QinghuaYao/ECE445-notebook/Michael/notebook.md

# Date: Week of 2/3
https://www.espressif.com/en/products/socs/esp32 <br> https://docs.espressif.com/projects/esp-idf/en/v4.4/esp32s3/api-reference/peripherals/gpio.html <br>
The ESP32 is a low-cost, low-power system on a chip (SoC) with integrated Wi-Fi and Bluetooth, widely used in embedded systems and Internet of Things (IoT) projects. It’s developed by Espressif Systems, a company based in Shanghai.

<br>
Key Features:<br>
- Dual-core Tensilica Xtensa LX6 (or single-core in some variants) <br>
- Wi-Fi (802.11 b/g/n) and Bluetooth 4.2 / BLE <br>
- Up to 520 KB SRAM and support for external flash <br>
- GPIOs, ADC, DAC, UART, SPI, I2C, PWM, and more <br>
- Ultra-low power modes for battery-powered applications <br>
- Integrated Hall sensor and temperature sensor
<br>
ESP32 can be interfaced with other systems to provide WiFi and Bluetooth functionality through SPI / SDIO or I2C / UART interfaces. 

# Date: Week of 2/10
MPU6050 for acceleration data <br>

6-axis MEMS motion tracking device developed by InvenSense (now part of TDK). It combines a 3-axis gyroscope and a 3-axis accelerometer in a single chip, making it ideal for motion-sensing and orientation-tracking applications.<br>

6 Degrees of Freedom (DoF):<br>
- 3-axis accelerometer (±2g, ±4g, ±8g, ±16g)
- 3-axis gyroscope (±250, ±500, ±1000, ±2000 °/sec)
Digital Motion Processor (DMP):
- Onboard processor that can compute complex motion processing algorithms (e.g., sensor fusion) internally, reducing the load on the main microcontroller.
- I²C and SPI communication support
- 16-bit ADCs for each axis (high resolution)
- Power supply: 2.3V–3.4V (typically 3.3V)
<br>
Accelerometer: Measures linear acceleration (e.g., gravity, movement). <br>
Gyroscope: Measures angular velocity (rotation rate). <br>
Temperature sensor: Provides die temperature reading (useful for compensation). <br>

# Date: Week of 2/17
Mostly preparing for proposal review and get started with the PCB

# Date: Week of 2/24
Attached a schematic of our PCB <br>

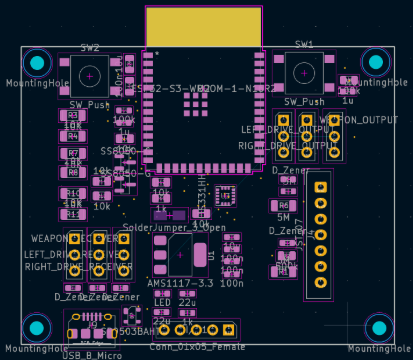
[picture p1: Michael/PCB.png]
PCB


Following is the MPU6050 Pinout <br>
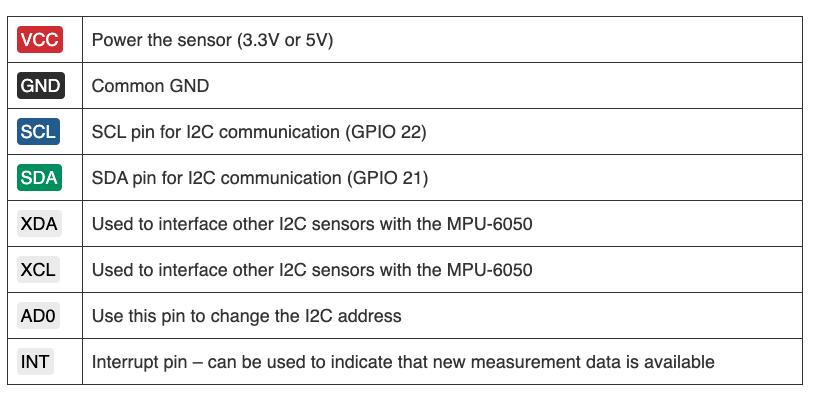
[picture p2: Michael/MPU_Pinout.png]
MPU Pinout


Following is the schematic <br>
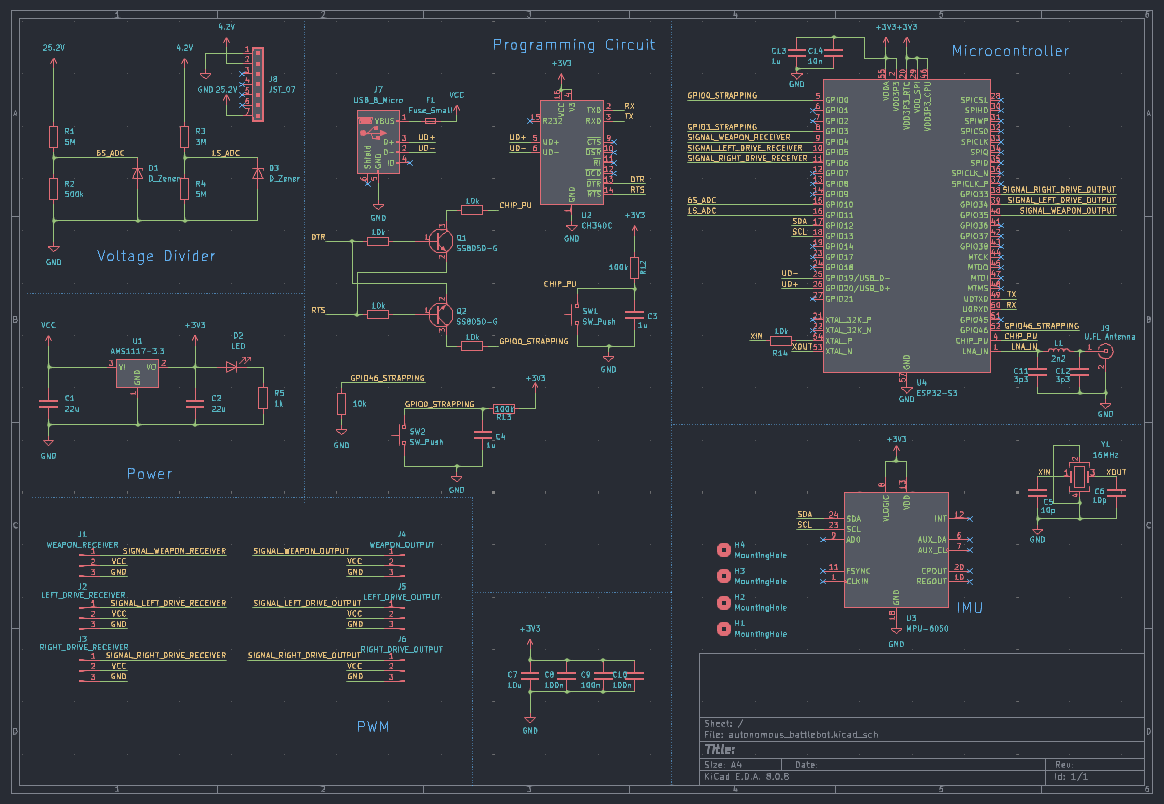
[picture p3: Michael/Schematic.png]
Schematic


After TA meeting and PCB review, everything looks good and I will ordering all the parts. <br>

Update: Order has been done over the weekend.

# Date: Week of 3/3
PCB order has been gone through. <br>

Waiting for the parts to arrive so we can start assembling. <br>

Start working on the design document and start preparing for the breadboard demonstration.<br>

For breadboard demo, we will be showing the AprilTag conversion and basic ESP32 board demonstration using Arduino IDE to test out the acceleration. <br>

https://randomnerdtutorials.com/esp32-mpu-6050-accelerometer-gyroscope-arduino/ <br>

Will be using this tutorial as reference <br>

Uploaded the acceleration.ino for demo

# Date: Week of 3/10
Completed the breadboard demo <br>

Double-check the connection with Bluetooth 
- Doesn't work that well.. Maybe WiFi?
<br>

Not much work done with the parts yet

# Date: Week of 3/17
Spring Break

# Date: Week of 3/24
Missed TA meeting due to midterm <br>

Work on individual progress reports <br>

Placed all the orders for PCB <br>

Update: IMU CHANGE <br>

Changes with IMU as MPU6050 is no longer available <br>

Will be using LIS331 <br>

https://mm.digikey.com/Volume0/opasdata/d220001/medias/docus/2319/LIS331DLH%28TR%29.pdf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 <br>

LIS331 IMU for acceleration data <br>

3-axis MEMS accelerometers developed by STMicroelectronics, designed to measure acceleration in three dimensions (X, Y, and Z). It's often used in applications like motion sensing, gesture recognition, tilt detection, and vibration monitoring.
<br>

Key Features (for LIS331DLH, a common variant):
- Measurement Range: ±2g / ±4g / ±8g (selectable)
- Resolution: 12-bit or higher
- Communication Interfaces:
- I²C
- SPI
- Low power consumption, suitable for battery-operated devices
- Embedded functions:
- Free-fall detection
- Tap/double-tap recognition
- Click and activity detection
<br>
https://www.st.com/resource/en/datasheet/lis331dlh.pdf

# Date: Week of 3/31
Finish up individual progress report <br>

Robobrawl competition is coming up.. We won't be able to work on the robot over the weekend due to the competition <br>

Still waiting for the PCB parts to arrive

# Date: Week of 4/7
Started assembling and soldering the parts as everything arrived <br>

Need more diodes and resistors <br>

Also realized that we should be using a different ESP32 module 

# Date: Week of 4/14 <br>
Reordered all the necessary parts we need <br>

Also need to order stencil as the PCB is too small to solder without a stencil<br>

We also did not have enough solder paste so we ordered extra solder paste <br>

# Date: Week of 4/21
Prepare for mock demo <br>

PCB is not ready due to the parts still arriving (Stencil is stuck in customs) <br>

Only would be showing the software parts
- AprilTag detections
- Robot following along the RC car

# Date: Week of 4/28
Prepare for final demo, mock presentation, and extra credit video <br>

We had our PCB working, have gone through voltage divider test and IMU acceleration test.<br>

Video for the following test: <br>

IMU video was too large and exceeded the file size limit. The table is still provided below. <br>

Voltage Divider Test
<br>
The results were the following. <br>

IMU Test Table
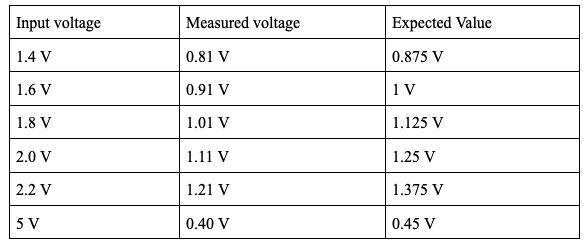
[picture p4: Michael/Voltage_Divider_Test.png]
Voltage Divider Test Table

<br>
For the voltage divider test, the expected value will use the following formula: Vout = (Vin × R2 ) /(R1 + R2)

Our final PCB looks like the following: <br>
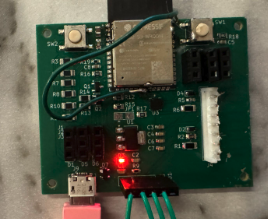
[picture p5: Michael/PCBPhoto.png]
PCB Final


Unfortunately, we were only able to have output in the serial monitor and was not able to upload anything
-Possible soldering issue with the RX pin
-Not enough time to fix the PCB

# Date: Week of 5/5
Work on final presentation and paper
