QinghuaYao/ECE445-notebook/Qing/notebook.md

# 02/24/2025
## ESP32-S3

### GPIO
more info:
https://docs.espressif.com/projects/esp-idf/en/v4.4/esp32s3/api-reference/peripherals/gpio.html
ESP32-S3 features 45 GPIO pads.
Some GPIO pads cannot be used or do not have the corresponding pin on the chip package.
Each pad can be used as a general purpose I/O or can be connected to an internal peripheral signal.

### ADC (analog to digital converter)
Detailed info of ADC:
https://docs.espressif.com/projects/arduino-esp32/en/latest/api/adc.html
https://docs.espressif.com/projects/esp-idf/en/v4.4/esp32s3/api-reference/peripherals/adc.html
We will use this peripheral to monitor the battery of the battlebot.
This peripheral will convert analog signal, such as voltage, into digital signal so that it can be read and processed by the microcontroller

These channels are supported:

ADC1:

        10 channels: GPIO1 - GPIO10

ADC2:

        10 channels: GPIO11 - GPIO20

For now, I choose **GPIO1** and **GPIO2** for **ADC** usage (I may change it if we come up with better design)
#### ADC Attenuation
The largest voltage ESP32S3 could handle with is 1.1V, so ADC attenuation is needed for processing larger voltage.
The largest voltage ESP32S3 can handle with is 3.3 V, which is still larger than the battery voltage, so we decide to use a voltage divider.
##### Calculation:
TBD

### Inter-Integrated Circuit (I2C)
https://docs.espressif.com/projects/arduino-esp32/en/latest/api/i2c.html
https://docs.espressif.com/projects/esp-idf/en/v4.4/esp32s3/api-reference/peripherals/i2c.html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
I2C is a serial, synchronous, half-duplex communication protocol that allows co-existence of multiple masters and slaves on the same bus. The I2C bus consists of two lines: serial data line (SDA) and serial clock (SCL). Both lines require pull-up resistors.

**MPU 6050** uses this protocol to communicate with ESP32-S3
On the Generic ESP32 the default I2C pins are:

    sdaPin GPIO21

    sclPin GPIO22

However, there is no GPIO22 on ESP32-S3. Instead, I will choose **GPIO8** for **sdaPin** and **GPIO9** for **sclPin**

### Power supply
• When using a single power supply, the recommended power supply voltage is 3.3 V and the output current is
no less than 500 mA.
• It is suggested to add an ESD protection diode at the power entrance
**Decoupling capacitors** need to be considered

reference: 
https://docs.espressif.com/projects/esp-idf/en/v4.4/esp32s3/api-reference/peripherals/index.html
https://docs.espressif.com/projects/arduino-esp32/en/latest/libraries.html#datasheet

# 02/27/2025
Design changes:
GPIO 4-9 : for PWM signal
GPIO 10,11: for MPU6050 signal (SDA, SCL)

**ESP32S3 hardware guideline**
https://docs.espressif.com/projects/esp-hardware-design-guidelines/en/latest/esp32s3/esp-hardware-design-guidelines-en-master-esp32s3.pdf
## external cyrstal clock for ESP32S3
$$
C_1 = C_2 = 2 \times (C_L - C_{\text{stray}})
$$

# 03/09/2025

## bread boad demo
we decide to demo the battery reading subsystem

The democode is called Demo_Code_ECE445

# 03/13/2025

Test the Bluetooth Functionality again. Test result could be checked in img/BlueTooth_test.png

# 03/20/2025
## WiFi connection
### 3 wifi modes
1. Station mode(STA):
   the ESP32 connects to other existing networks (like your router at home or any other access point)
   code: WiFi.mode(WIFI_STA);
2. Access Point Mode(AP):
   the ESP32 creates its own network by acting as an access point that other WiFi stations can connect to it
   code: WiFi.mode(WIFI_AP);
3. Access Point + Station Mode (AP_STA):
   in this mode, the ESP32 WiFi will act as both Access Point and WiFi Station Simultaneously
   code: WiFi.mode(WIFI_AP_STA);
We will use STA mode for this project since we want to send data between ESP32 and a computer
https://deepbluembedded.com/esp32-wifi-library-examples-tutorial-arduino/

# 03/27/2025

Test the Wi-Fi functionality of ESP32-S3. Code can be found in Wifi_transfer.ino (for hardware) and Wifi.py (for test latency)

the test result is in img/WiFi_test and WiFi_test1

However, both WiFi and the Bluetooth are slow and low-efficient. Jason decides to use ESP-NOW

# 04/07/2025

redesign the schematic and the PCB

Add I/O ports, voltage divider for PWM inputs

Changed the IMU to LIS331(data sheet is in this folder)

Changes the MCU to ESP32S3-Wroom-1, don't have to consider cystals

# 04/17/2025

Try to solder the PCB without stencil

failed because it's difficult to solder the IMU and ESP32S3 with hands

# 04/27/2025

Finished soldering

# 04/29/2025

Test the PCB, the results are shown in videos
https://drive.google.com/file/d/1Wf_zj_Yllhc7Nl9g81vWwoR2AeOOUYyU/view?usp=sharing
https://drive.google.com/file/d/1DK5xYzDkgq6wUjl2HwUs8gxq-mtZnsGS/view?usp=sharing
