QinghuaYao/ECE445-notebook/Qing/img/External_Crystal.png

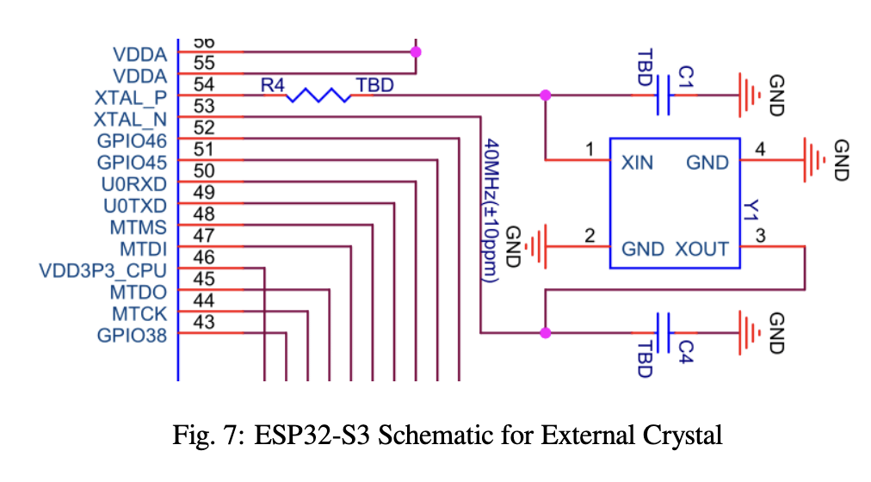
Qing/img/External_Crystal.png
