QinghuaYao/ECE445-notebook/Qing/img/PCB_photo.jpg

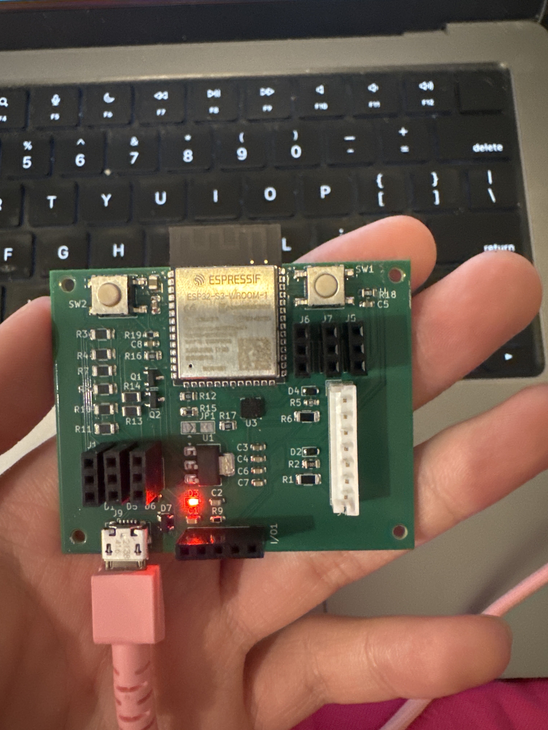
Qing/img/PCB_photo.jpg
