QinghuaYao/ECE445-notebook/Qing/img/Schematic-v1.png

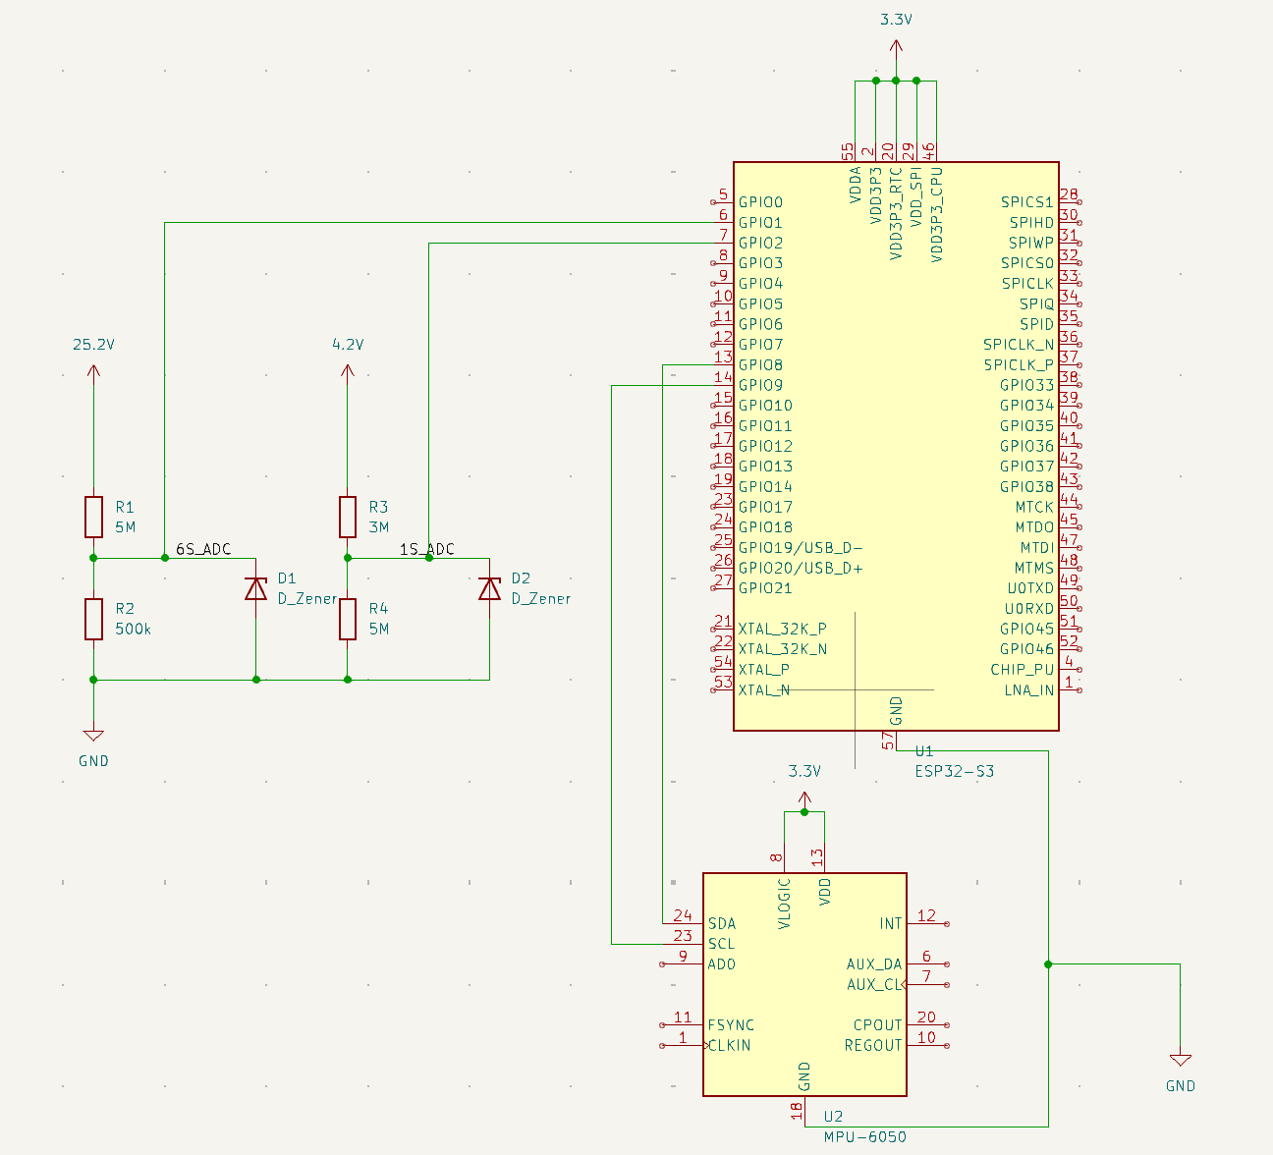
Qing/img/Schematic-v1.png
