QinghuaYao/ECE445-notebook/Qing/img/BlueTooth_test.png

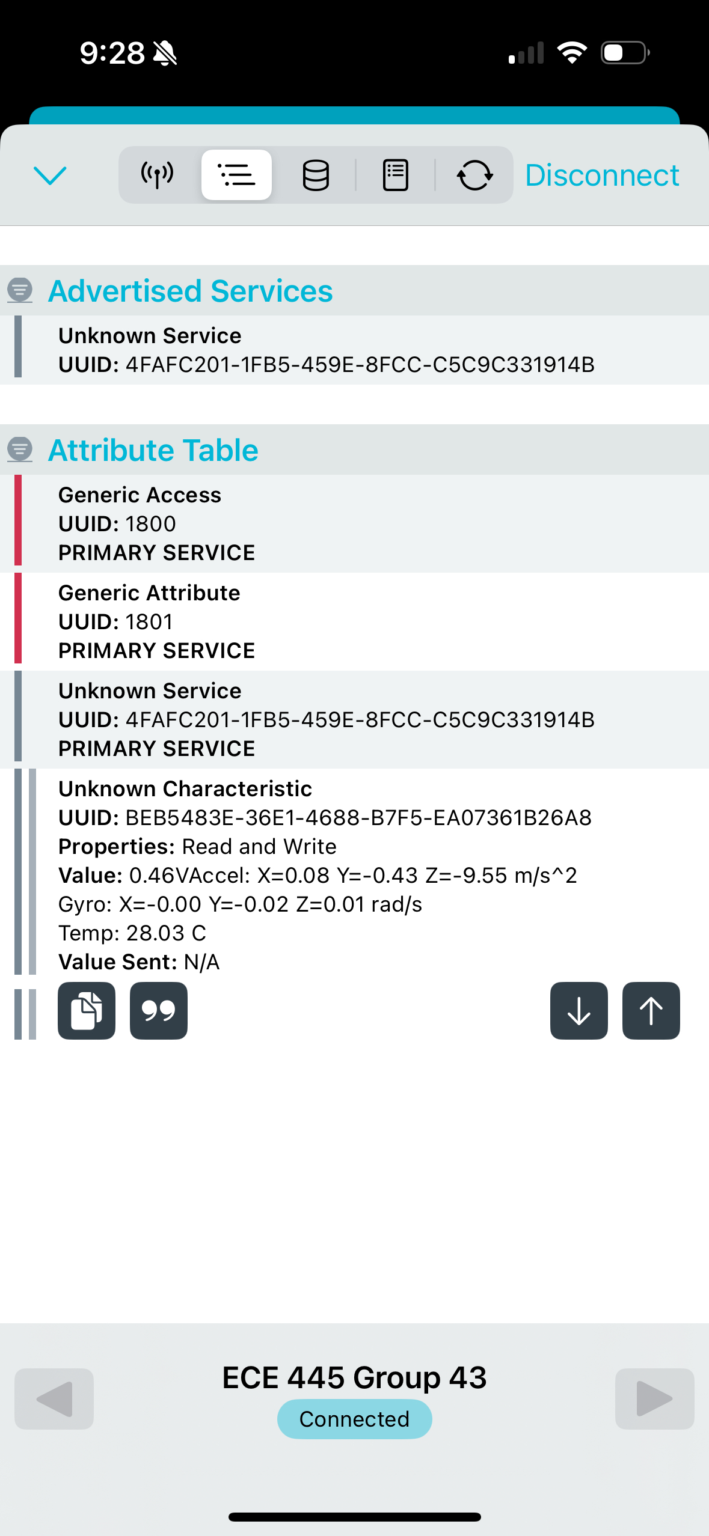
Qing/img/BlueTooth_test.png
