QinghuaYao/ECE445-notebook/Qing/img/WiFi_test1.png

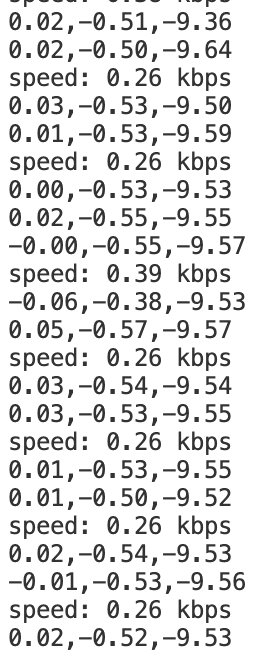
Qing/img/WiFi_test1.png
