QinghuaYao/ECE445-notebook/Qing/Schematic_and_PCB/Autonomous_Bot.kicad_pcb

## KiCad design Qing/Schematic_and_PCB/Autonomous_Bot.kicad_pcb (2025-05-09)

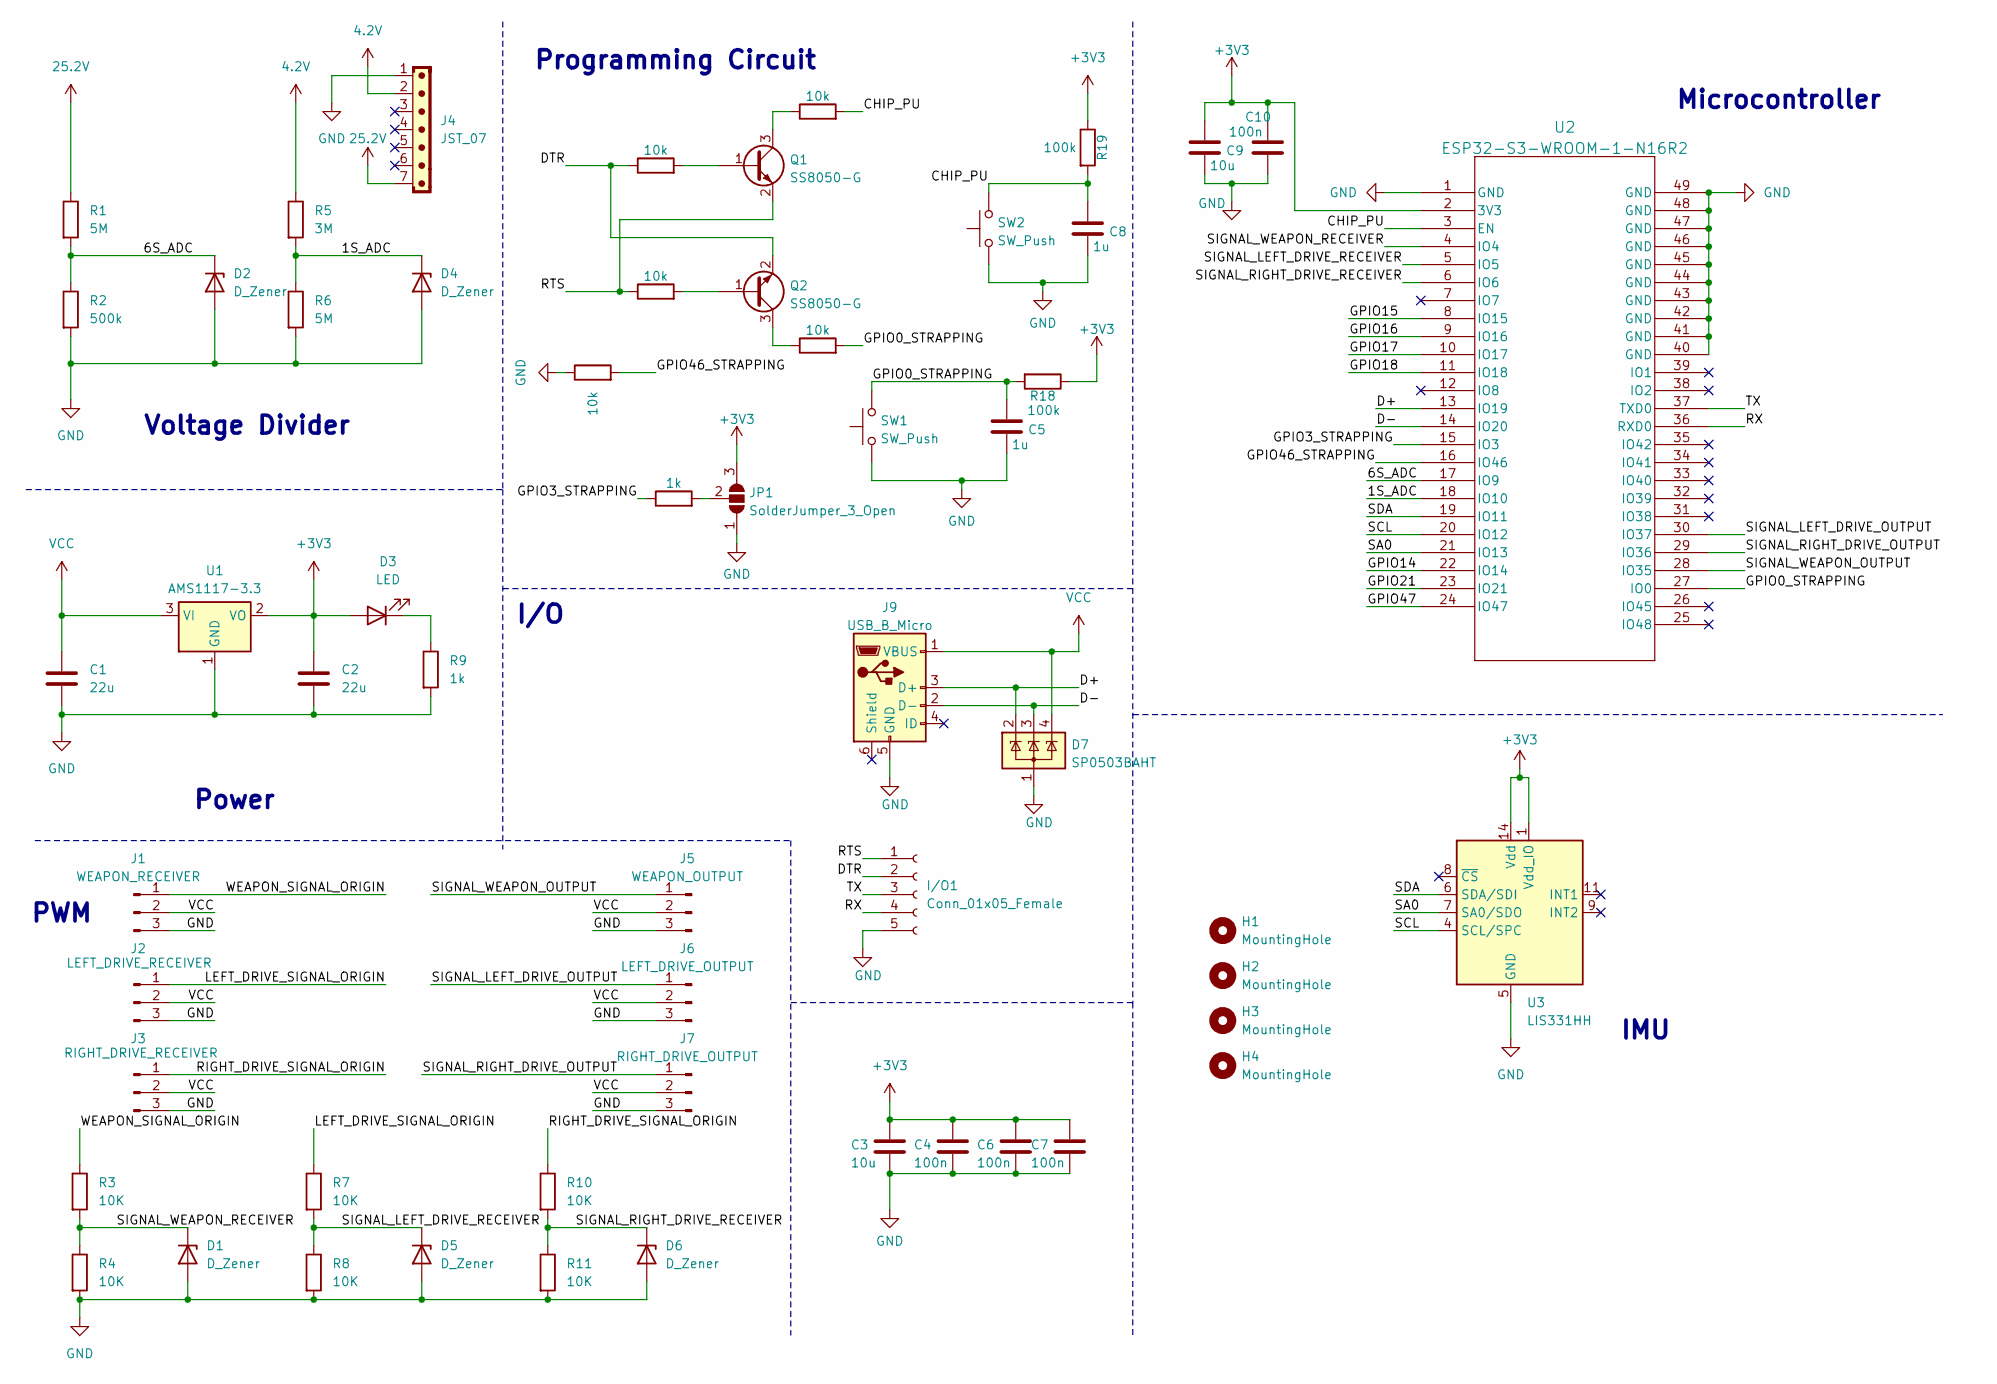
[picture p15: schematic Autonomous_Bot.kicad_sch]

Parts:
C1, C2: 22u; C_0603_1608Metric
C3: 10u; C_0603_1608Metric
C4, C6, C7: 100n; C_0603_1608Metric
C5, C8: 1u; C_0603_1608Metric
C9: 10u; C_0805_2012Metric
C10: 100n; C_0805_2012Metric
D1, D2, D4, D5, D6: D_Zener; D_0603_1608Metric
D3: LED; LED_0603_1608Metric
D7: SP0503BAHT; SOT-143
H1, H2, H3, H4: MountingHole; MountingHole_2.2mm_M2
I/O1: Conn_01x05_Female; PinHeader_1x05_P2.54mm_Vertical
J1: WEAPON_RECEIVER; PinHeader_1x03_P2.54mm_Vertical
J2: LEFT_DRIVE_RECEIVER; PinHeader_1x03_P2.54mm_Vertical
J3: RIGHT_DRIVE_RECEIVER; PinHeader_1x03_P2.54mm_Vertical
J4: JST_07; JST_EH_B7B-EH-A_1x07_P2.50mm_Vertical
J5: WEAPON_OUTPUT; PinHeader_1x03_P2.54mm_Vertical
J6: LEFT_DRIVE_OUTPUT; PinHeader_1x03_P2.54mm_Vertical
J7: RIGHT_DRIVE_OUTPUT; PinHeader_1x03_P2.54mm_Vertical
J9: USB_B_Micro; USB_Micro-B_Amphenol_10118194_Horizontal
JP1: SolderJumper_3_Open; SolderJumper-3_P2.0mm_Open_TrianglePad1.0x1.5mm
Q1, Q2: SS8050-G; SOT-23
R1, R6: 5M; R_1206_3216Metric
R2: 500k; R_0805_2012Metric
R3, R4, R7, R8, R10, R11: 10K; R_1206_3216Metric
R5: 3M; R_0603_1608Metric
R9: 1k; R_0603_1608Metric
R12, R13, R14, R16, R17: 10k; R_0805_2012Metric
R15: 1k; R_0805_2012Metric
R18: 100k; R_0805_2012Metric
R19: 100k; R_0603_1608Metric
SW1, SW2: SW_Push; SW_SPST_B3S-1000
U1: AMS1117-3.3; SOT-223-3_TabPin2
U2: ESP32-S3-WROOM-1-N16R2; ESP32-S3-WROOM-1_EXP
U3: LIS331HH; LGA-16_3x3mm_P0.5mm_LayoutBorder3x5y

Connections:
4.2V: J4.2, R5.1
25.2V: J4.7, R1.1
+3V3: C2.1, C3.1, C4.1, C6.1, C7.1, C9.1, C10.1, D3.2 (A), JP1.3 (B), R18.1, R19.1, U1.2 (VO), U2.2 (3V3), U3.1 (Vdd_IO), U3.14 (Vdd), U3.15 (Vdd)
/1S_ADC: D4.1 (K), R5.2, R6.1, U2.18 (IO10)
/6S_ADC: D2.1 (K), R1.2, R2.1, U2.17 (IO9)
/CHIP_PU: C8.1, R16.2, R19.2, SW2.2, U2.3 (EN)
/D+: D7.2 (K), J9.3 (D+), U2.13 (IO19)
/D-: D7.3 (K), J9.2 (D-), U2.14 (IO20)
/DTR: I/O1.2, Q2.2 (E), R13.1
/GPIO0_STRAPPING: C5.1, R17.2, R18.2, SW1.2, U2.27 (IO0)
/GPIO3_STRAPPING: R15.1, U2.15 (IO3)
/GPIO14: U2.22 (IO14)
/GPIO15: U2.8 (IO15)
/GPIO16: U2.9 (IO16)
/GPIO17: U2.10 (IO17)
/GPIO18: U2.11 (IO18)
/GPIO21: U2.23 (IO21)
/GPIO46_STRAPPING: R12.2, U2.16 (IO46)
/GPIO47: U2.24 (IO47)
/LEFT_DRIVE_SIGNAL_ORIGIN: J2.1, R7.1
/RIGHT_DRIVE_SIGNAL_ORIGIN: J3.1, R10.1
/RTS: I/O1.1, Q1.2 (E), R14.1
/RX: I/O1.4, U2.36 (RXD0)
/SA0: U2.21 (IO13), U3.7 (SA0/SDO)
/SCL: U2.20 (IO12), U3.4 (SCL/SPC)
/SDA: U2.19 (IO11), U3.6 (SDA/SDI)
/SIGNAL_LEFT_DRIVE_OUTPUT: J6.1, U2.30 (IO37)
/SIGNAL_LEFT_DRIVE_RECEIVER: D5.1 (K), R7.2, R8.1, U2.5 (IO5)
/SIGNAL_RIGHT_DRIVE_OUTPUT: J7.1, U2.29 (IO36)
/SIGNAL_RIGHT_DRIVE_RECEIVER: D6.1 (K), R10.2, R11.1, U2.6 (IO6)
/SIGNAL_WEAPON_OUTPUT: J5.1, U2.28 (IO35)
/SIGNAL_WEAPON_RECEIVER: D1.1 (K), R3.2, R4.1, U2.4 (IO4)
/TX: I/O1.3, U2.37 (TXD0)
/WEAPON_SIGNAL_ORIGIN: J1.1, R3.1
GND: C1.2, C2.2, C3.2, C4.2, C5.2, C6.2, C7.2, C8.2, C9.2, C10.2, D1.2 (A), D2.2 (A), D4.2 (A), D5.2 (A), D6.2 (A), D7.1 (A), I/O1.5, J1.3, J2.3, J3.3, J4.1, J5.3, J6.3, J7.3, J9.5 (GND), JP1.1 (A), R2.2, R4.2, R6.2, R8.2, R9.2, R11.2, R12.1, SW1.1, SW2.1, U1.1 (GND), U2.1 (GND), U2.40 (GND), U2.41 (GND), U2.42 (GND), U2.43 (GND), U2.44 (GND), U2.45 (GND), U2.46 (GND), U2.47 (GND), U2.48 (GND), U2.49 (GND), U3.5 (GND), U3.10 (GND), U3.12 (GND), U3.13 (GND), U3.16 (GND)
unnamed: D3.1 (K), R9.1
unnamed: JP1.2 (C), R15.2
unnamed: Q1.1 (B), R13.2
unnamed: Q1.3 (C), R16.1
unnamed: Q2.1 (B), R14.2
unnamed: Q2.3 (C), R17.1
VCC: C1.1, D7.4 (K), J1.2, J2.2, J3.2, J5.2, J6.2, J7.2, J9.1 (VBUS), U1.3 (VI)

Notes on the sheet:
Power
IMU
Programming Circuit
Microcontroller
PWM
I/O
Voltage Divider

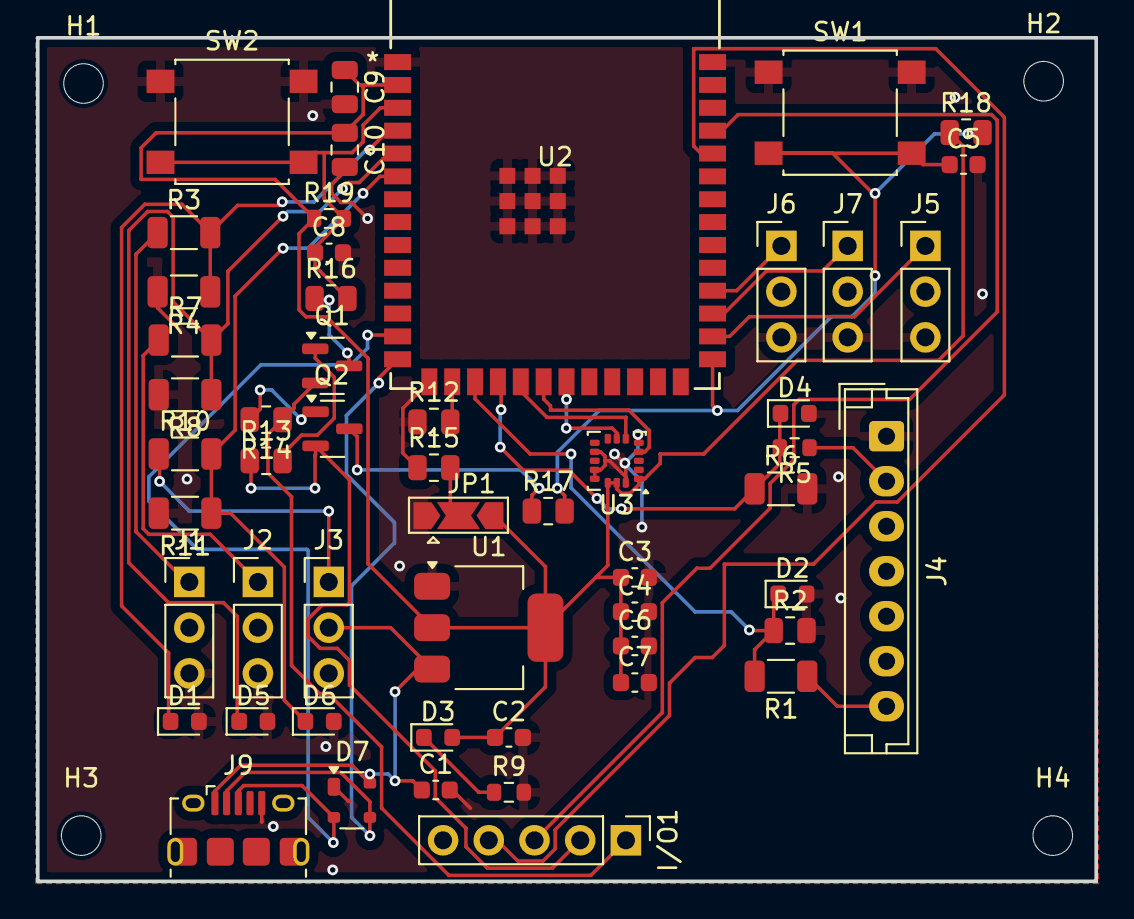
[picture p16: board Autonomous_Bot.kicad_pcb from above]

Board: 2 copper layers, 58.8 x 46.9 mm, 57 parts (0 on the bottom side), 35 nets.
