QinghuaYao/ECE445-notebook/Jason/autonomous_battlebot/autonomous_battlebot.kicad_pcb

## KiCad design Jason/autonomous_battlebot/autonomous_battlebot.kicad_pcb (2025-03-03)

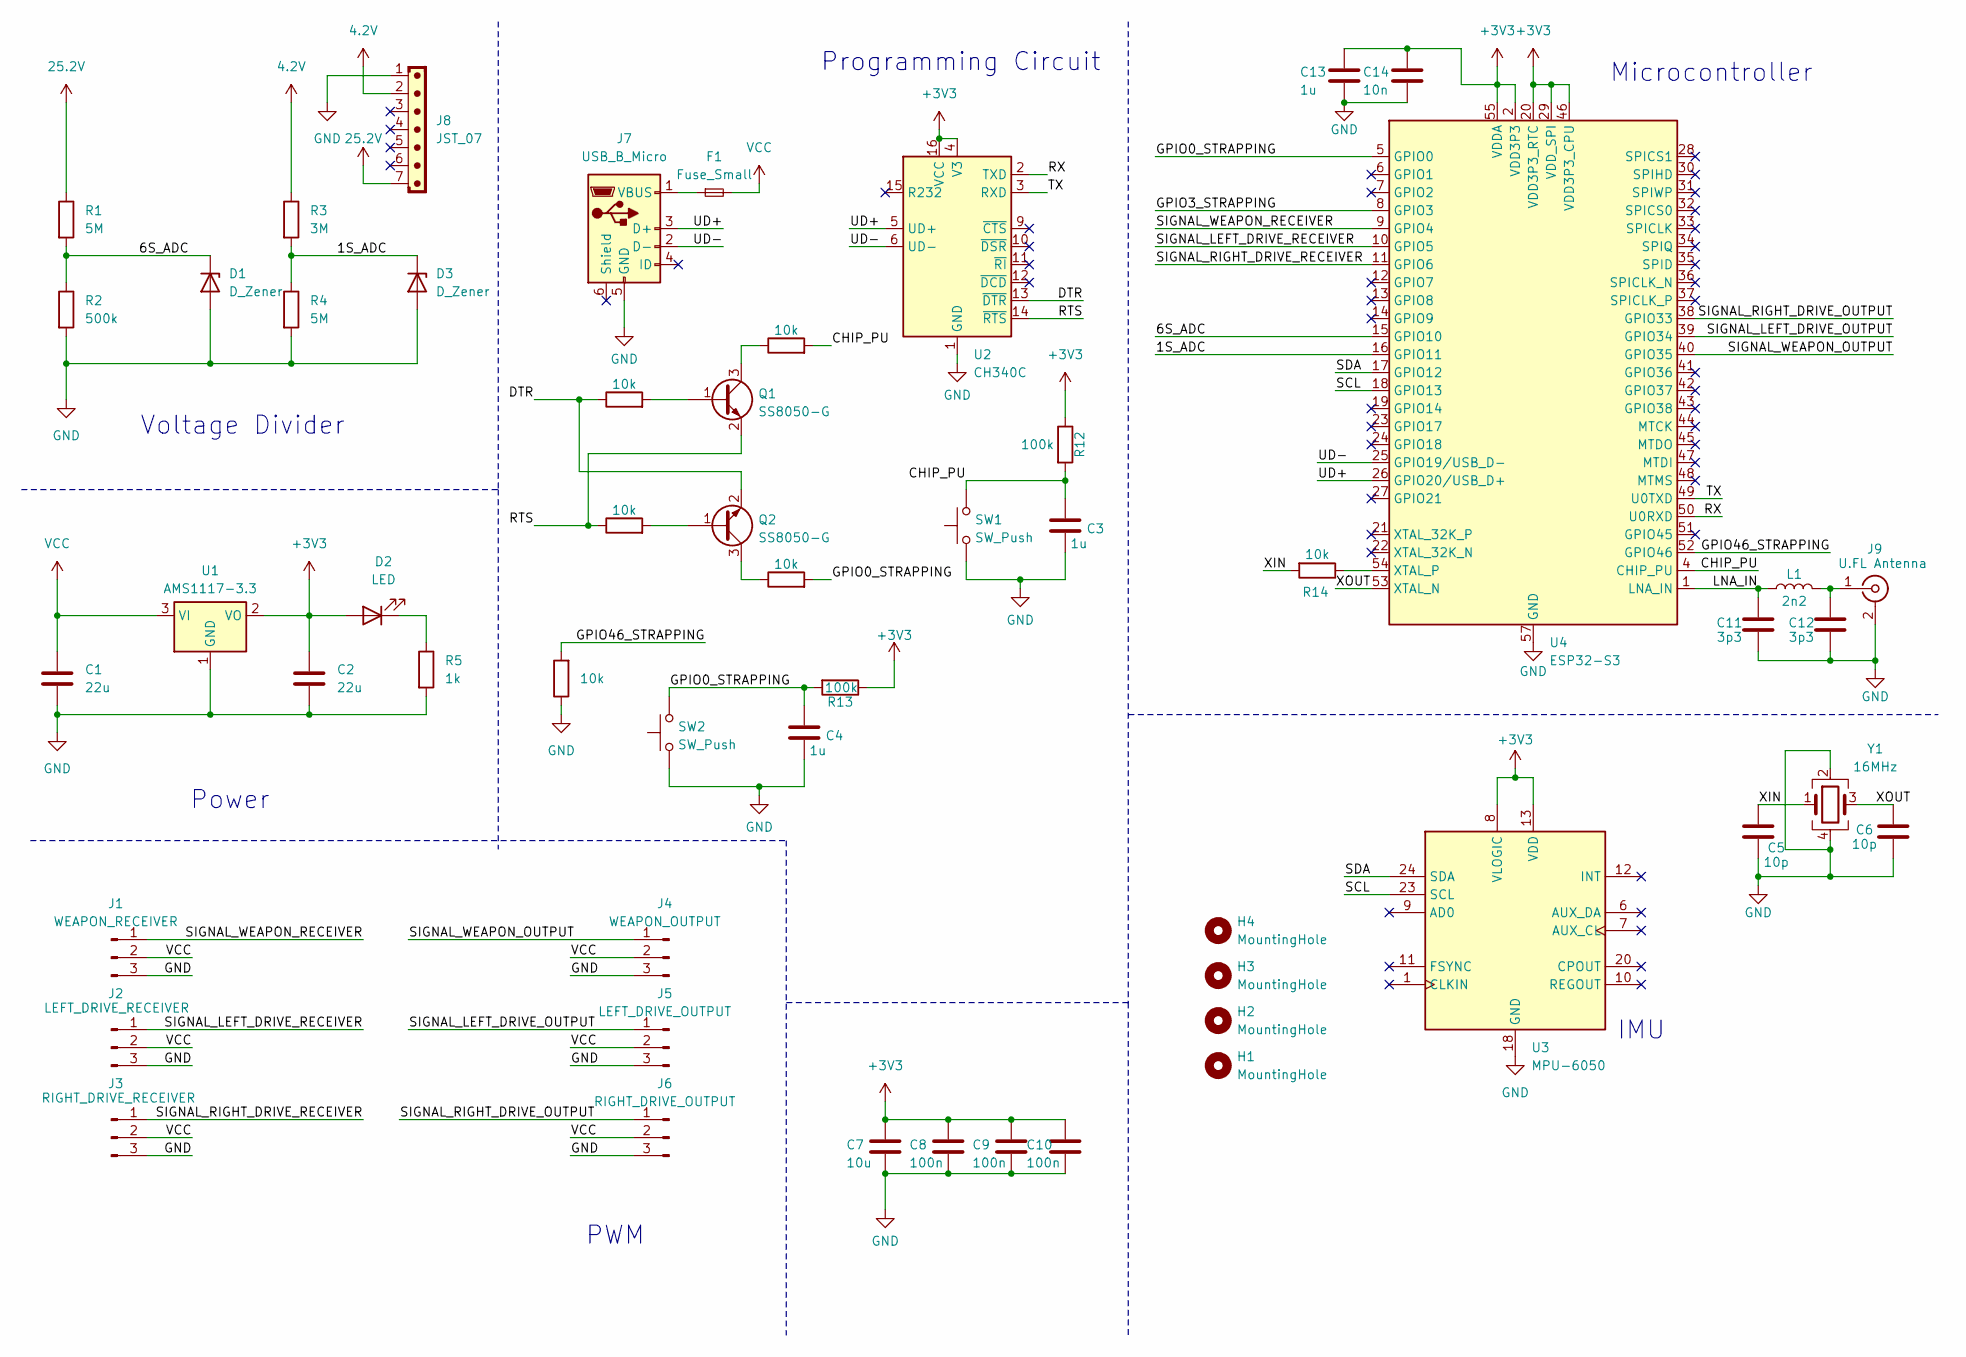
[picture p17: schematic autonomous_battlebot.kicad_sch]

Parts:
C1, C2: 22u; C_0603_1608Metric
C3, C4, C13: 1u; C_0603_1608Metric
C5, C6: 10p; C_0603_1608Metric
C7: 10u; C_0603_1608Metric
C8, C9, C10: 100n; C_0603_1608Metric
C11, C12: 3p3; C_0603_1608Metric
C14: 10n; C_0603_1608Metric
D1, D3: D_Zener; D_0603_1608Metric
D2: LED; LED_0603_1608Metric
F1: Fuse_Small; Fuse_0603_1608Metric
H1, H2, H3, H4: MountingHole; MountingHole_2.2mm_M2
J1: WEAPON_RECEIVER; PinHeader_1x03_P2.54mm_Vertical
J2: LEFT_DRIVE_RECEIVER; PinHeader_1x03_P2.54mm_Vertical
J3: RIGHT_DRIVE_RECEIVER; PinHeader_1x03_P2.54mm_Vertical
J4: WEAPON_OUTPUT; PinHeader_1x03_P2.54mm_Vertical
J5: LEFT_DRIVE_OUTPUT; PinHeader_1x03_P2.54mm_Vertical
J6: RIGHT_DRIVE_OUTPUT; PinHeader_1x03_P2.54mm_Vertical
J7: USB_B_Micro; USB_Micro-B_Molex-105017-0001
J8: JST_07; JST_EH_B7B-EH-A_1x07_P2.50mm_Vertical
J9: U.FL Antenna; U.FL_Molex_MCRF_73412-0110_Vertical
L1: 2n2; L_0603_1608Metric
Q1, Q2: SS8050-G; SOT-23
R1, R4: 5M; R_1206_3216Metric
R2: 500k; R_0805_2012Metric
R3: 3M; R_0603_1608Metric
R5: 1k; R_0603_1608Metric
R7, R8, R9, R10, R11, R14: 10k; R_0805_2012Metric
R12: 100k; R_0603_1608Metric
R13: 100k; R_0805_2012Metric
SW1, SW2: SW_Push; SW_SPST_B3S-1000
U1: AMS1117-3.3; SOT-223-3_TabPin2
U2: CH340C; SOIC-16_3.9x9.9mm_P1.27mm
U3: MPU-6050; InvenSense_QFN-24_4x4mm_P0.5mm
U4: ESP32-S3; QFN-56-1EP_7x7mm_P0.4mm_EP4x4mm
Y1: 16MHz; Crystal_SMD_3225-4Pin_3.2x2.5mm

Connections:
4.2V: J8.2, R3.1
25.2V: J8.7, R1.1
+3V3: C2.1, C7.1, C8.1, C9.1, C10.1, C13.1, C14.1, D2.2 (A), R12.1, R13.1, U1.2 (VO), U2.4 (V3), U2.16 (VCC), U3.8 (VLOGIC), U3.13 (VDD), U4.2 (VDD3P3), U4.3 (VDD3P3), U4.20 (VDD3P3_RTC), U4.29 (VDD_SPI), U4.46 (VDD3P3_CPU), U4.55 (VDDA), U4.56 (VDDA)
/1S_ADC: D3.1 (K), R3.2, R4.1, U4.16 (GPIO11)
/6S_ADC: D1.1 (K), R1.2, R2.1, U4.15 (GPIO10)
/CHIP_PU: C3.1, R10.2, R12.2, SW1.2, U4.4 (CHIP_PU)
/DTR: Q2.2 (E), R7.1, U2.13 (~DTR)
/GPIO0_STRAPPING: C4.1, R11.2, R13.2, SW2.2, U4.5 (GPIO0)
/GPIO3_STRAPPING: U4.8 (GPIO3)
/GPIO46_STRAPPING: R9.2, U4.52 (GPIO46)
/LNA_IN: C11.1, L1.1, U4.1 (LNA_IN)
/RTS: Q1.2 (E), R8.1, U2.14 (~RTS)
/RX: U2.2 (TXD), U4.50 (U0RXD)
/SCL: U3.23 (SCL), U4.18 (GPIO13)
/SDA: U3.24 (SDA), U4.17 (GPIO12)
/SIGNAL_LEFT_DRIVE_OUTPUT: J5.1, U4.39 (GPIO34)
/SIGNAL_LEFT_DRIVE_RECEIVER: J2.1, U4.10 (GPIO5)
/SIGNAL_RIGHT_DRIVE_OUTPUT: J6.1, U4.38 (GPIO33)
/SIGNAL_RIGHT_DRIVE_RECEIVER: J3.1, U4.11 (GPIO6)
/SIGNAL_WEAPON_OUTPUT: J4.1, U4.40 (GPIO35)
/SIGNAL_WEAPON_RECEIVER: J1.1, U4.9 (GPIO4)
/TX: U2.3 (RXD), U4.49 (U0TXD)
/UD+: J7.3 (D+), U2.5 (UD+), U4.26 (GPIO20/USB_D+)
/UD-: J7.2 (D-), U2.6 (UD-), U4.25 (GPIO19/USB_D-)
/XIN: C5.1, R14.2, Y1.1
/XOUT: C6.1, U4.53 (XTAL_N), Y1.3
GND: C1.2, C2.2, C3.2, C4.2, C5.2, C6.2, C7.2, C8.2, C9.2, C10.2, C11.2, C12.2, C13.2, C14.2, D1.2 (A), D3.2 (A), J1.3, J2.3, J3.3, J4.3, J5.3, J6.3, J7.5 (GND), J8.1, J9.2 (Ext), R2.2, R4.2, R5.2, R9.1, SW1.1, SW2.1, U1.1 (GND), U2.1 (GND), U3.18 (GND), U4.57 (GND), Y1.2, Y1.4
unnamed: D2.1 (K), R5.1
unnamed: F1.1, J7.1 (VBUS)
unnamed: C12.1, J9.1 (In), L1.2
unnamed: Q1.1 (B), R7.2
unnamed: Q1.3 (C), R10.1
unnamed: Q2.1 (B), R8.2
unnamed: Q2.3 (C), R11.1
unnamed: R14.1, U4.54 (XTAL_P)
VCC: C1.1, F1.2, J1.2, J2.2, J3.2, J4.2, J5.2, J6.2, U1.3 (VI)

Notes on the sheet:
PWM
Microcontroller
Programming Circuit
Power
Voltage Divider
IMU

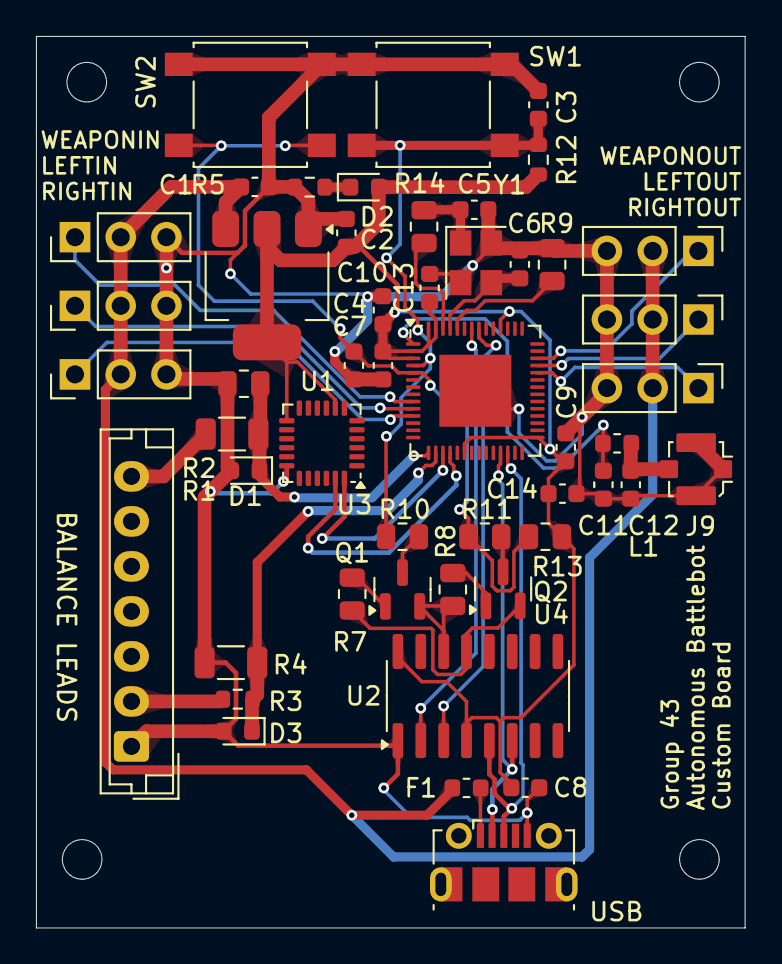
[picture p18: board autonomous_battlebot.kicad_pcb from above]

Board: 2 copper layers, 39.4 x 49.5 mm, 54 parts (0 on the bottom side), 35 nets.
