QinghuaYao/ECE445-notebook/(commit log)

2025-03-03 PCB upload #1
    [autonomous_battlebot.kicad_pcb, autonomous_battlebot.kicad_sch]
2025-04-23 Update arduino_client.ino 4/22
2025-05-09 update Qing's Notebook
    [Autonomous_Bot.kicad_pcb, Autonomous_Bot.kicad_sch]
